jcard0na/The-Open-Book/3d_models/README.md

The symbolic link button.step will be picked up in Kicad to render the buttons.
If you intend to use silicone keycaps, use:
ln -sf keycap-Body.step button.step
Else, for smd push buttons use:
ln -sf TS-1187A-B-A-B.step button.step
