jcard0na/The-Open-Book/3d_models/button.step

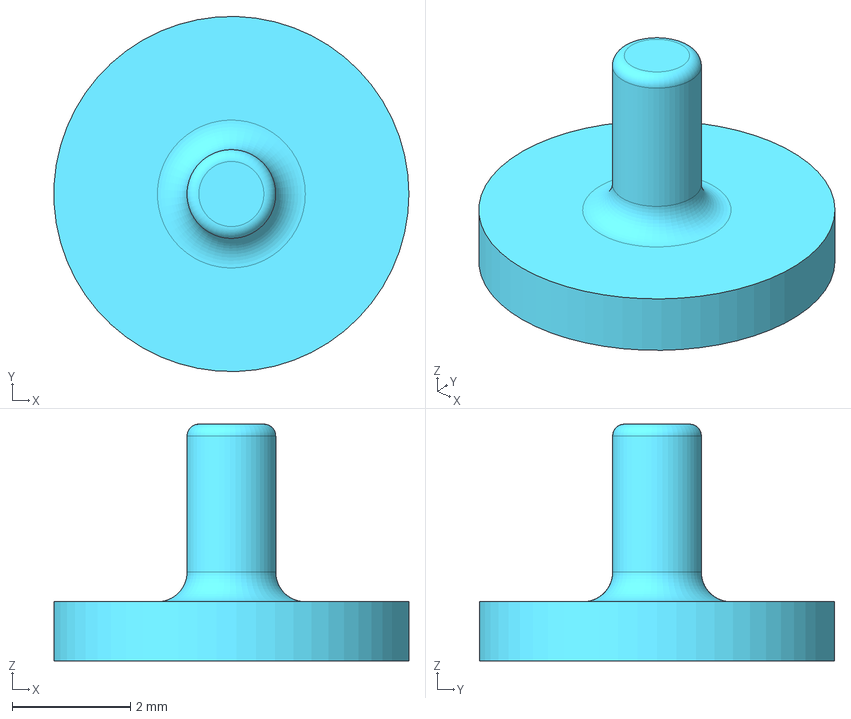
[picture p1: CAD file, 2024-09-22]
3d_models/button.step
6.00 x 6.00 x 4.00 mm
