jcard0na/The-Open-Book/3d_models/ST-TF-003A.step

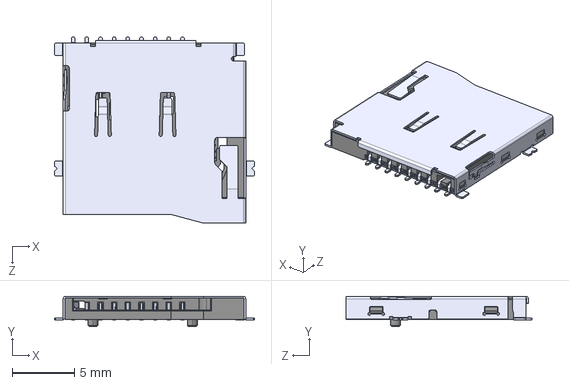
[picture p2: CAD file, 2024-09-21]
3d_models/ST-TF-003A.step
16.1 x 2.45 x 15.0 mm
