jcard0na/The-Open-Book/3d_models/TS-1187A-B-A-B.step

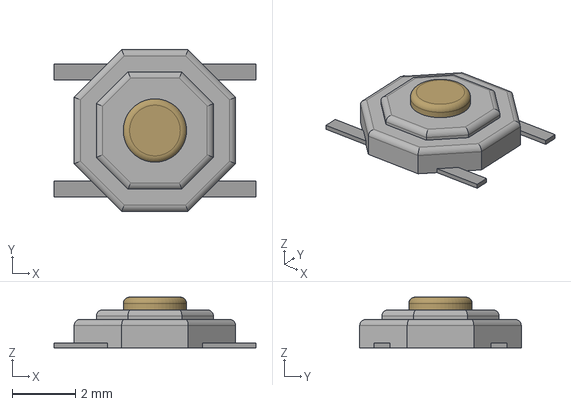
[picture p3: CAD file, 2024-09-21]
3d_models/TS-1187A-B-A-B.step
6.38 x 5.10 x 1.60 mm
