jcard0na/The-Open-Book/(list of files, cad)

Other CAD files:
3d_models/keycap.FCStd
