jcard0na/The-Open-Book/OSO-BOOK-B1/OSO-BOOK-B1.kicad_sch

## KiCad design OSO-BOOK-B1/OSO-BOOK-B1.kicad_sch (2025-03-12)

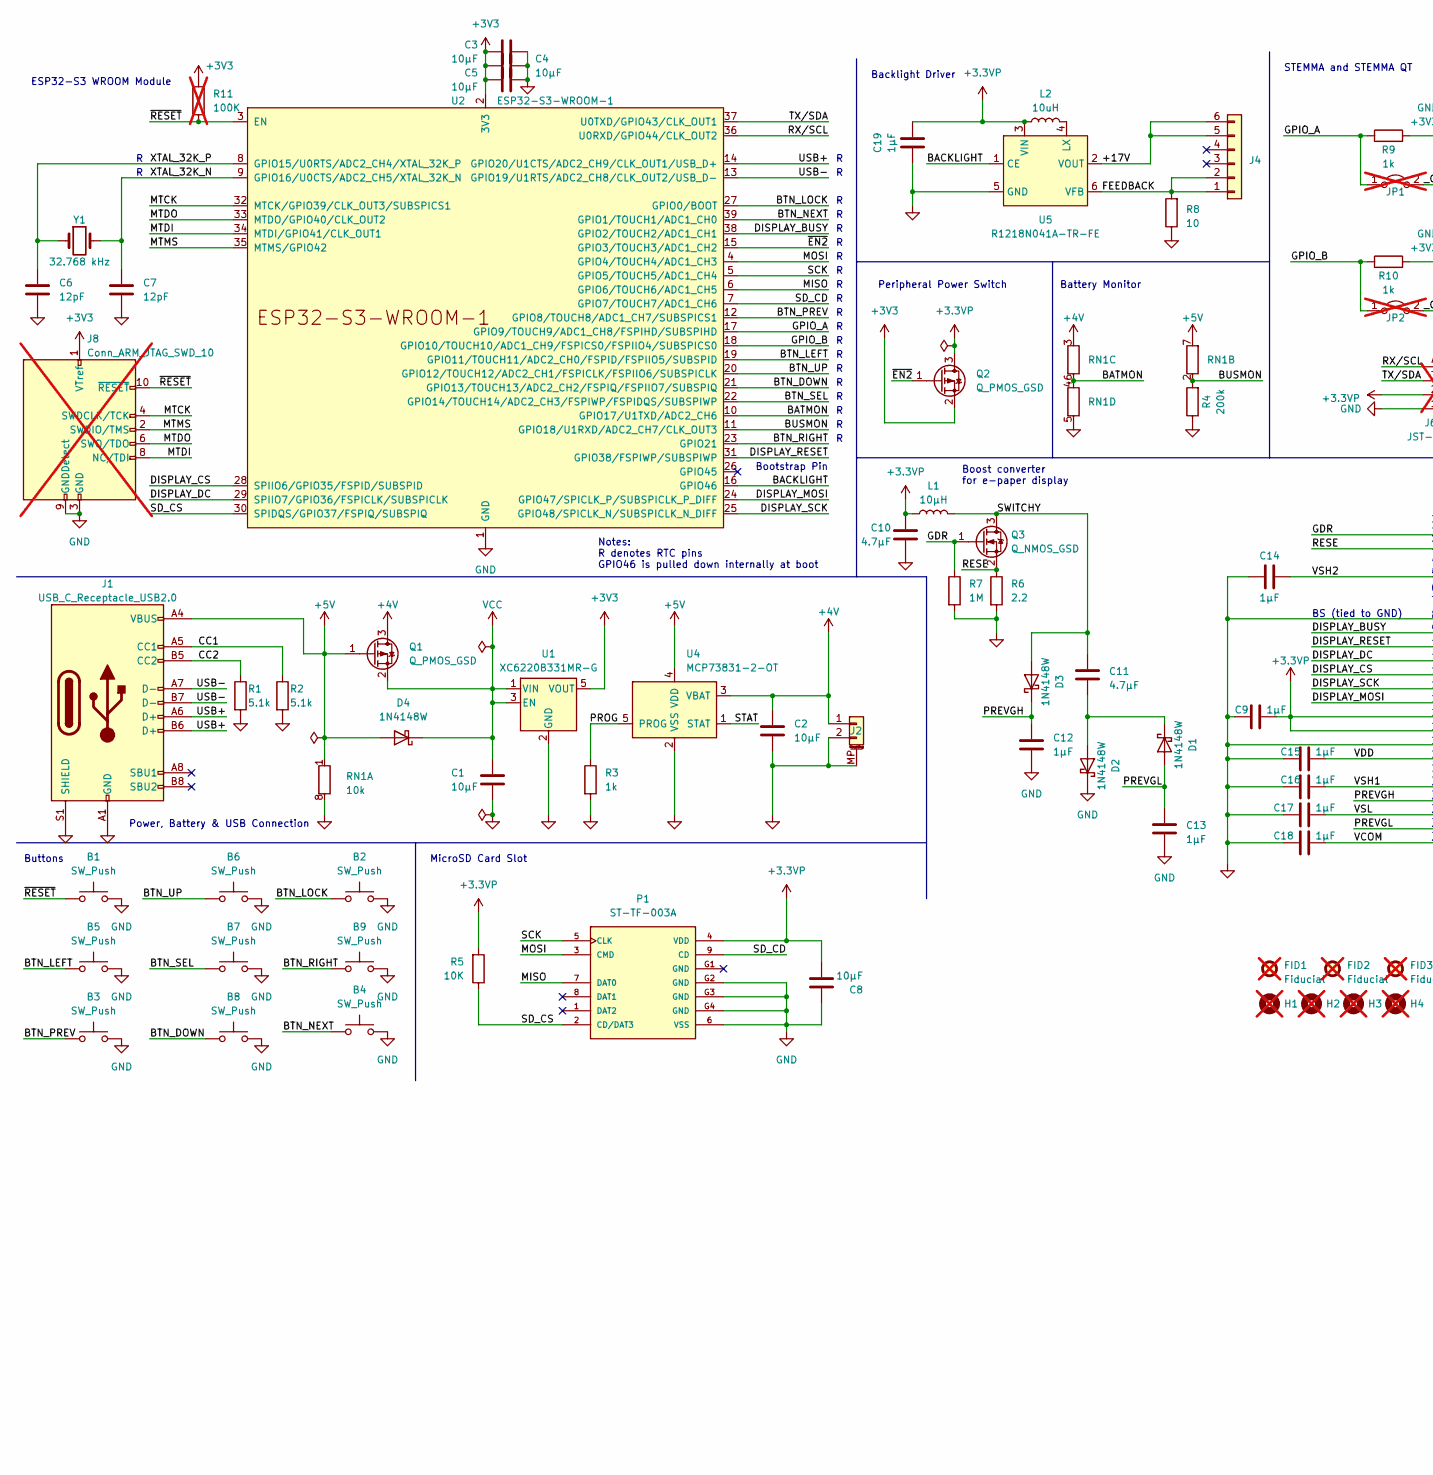
[picture p4: schematic OSO-BOOK-B1.kicad_sch, part in row 1, column 1]

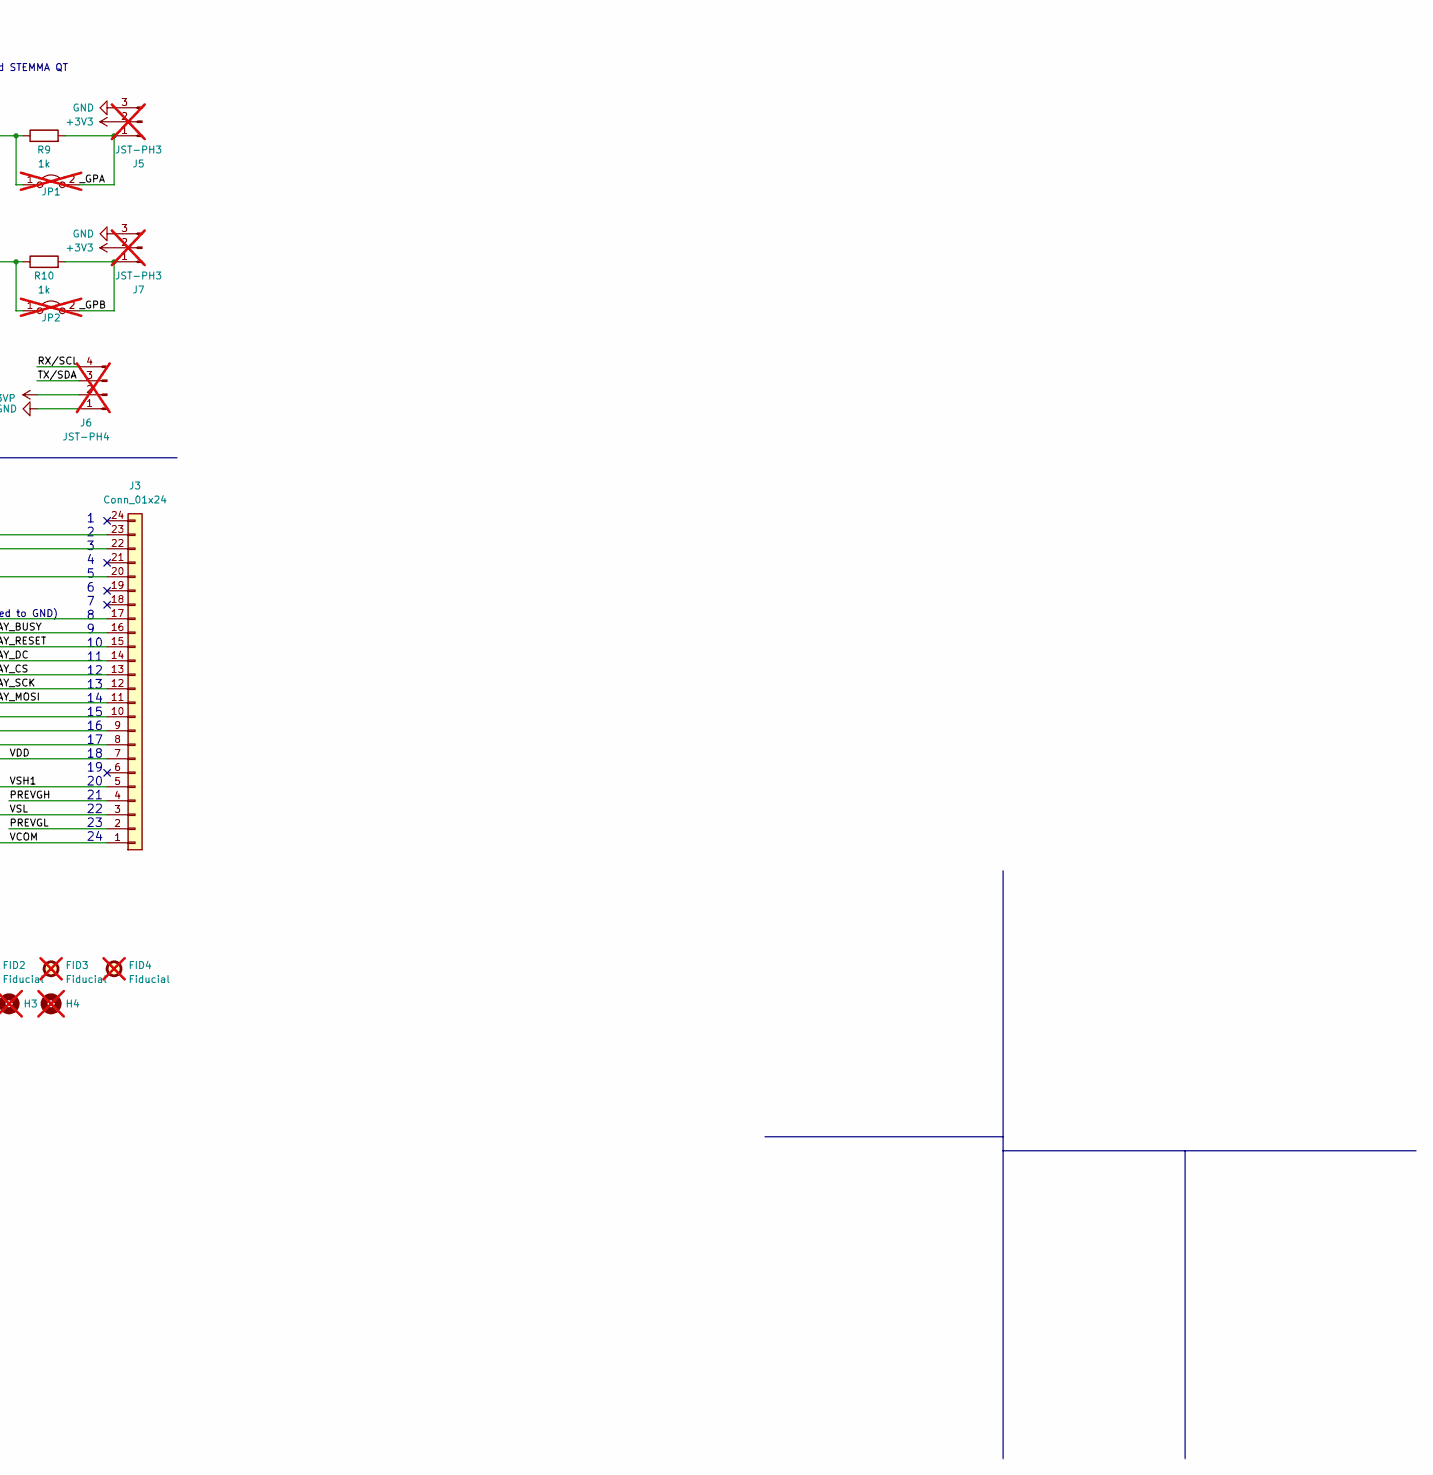
[picture p5: schematic OSO-BOOK-B1.kicad_sch, part in row 1, column 2]

Parts:
B1, B2: SW_Push; Panasonic_EVQPUJ_EVQPUA; JLCPCB C128539
B3, B4, B5, B6, B7, B8, B9: SW_Push; SW_Push_1P1T_XKB_TS-1187A-Silicon-Hybrid; JLCPCB C318884
C1, C2, C3, C4, C5, C8: 10µF; C_1206_3216Metric; JLCPCB C13585
C6, C7: 12pF; C_0603_1608Metric; JLCPCB C38523
C9, C12, C13, C14, C15, C16, C17, C18, C19: 1µF; C_0805_2012Metric; JLCPCB C28323
C10, C11: 4.7µF; C_0805_2012Metric; JLCPCB C1779
D1, D2, D3, D4: 1N4148W; D_SOD-123; JLCPCB C81598
FID1, FID2, FID3, FID4: Fiducial; Fiducial_1mm_Mask2mm; not fitted
H1, H2, H3, H4: MountingHole; MountingHole_2.7mm_M2.5; not fitted
J1: USB_C_Receptacle_USB2.0; USB_C_Receptacle_HRO_TYPE-C-31-M-12; JLCPCB C165948
J2: Conn_01x02_MountingPin; Molex_PicoBlade_53261-0271_1x02-1MP_P1.25mm_Horizontal; JLCPCB C225111
J3: Conn_01x24; TE_2-1734839-4_1x24-1MP_P0.5mm_Horizontal; JLCPCB C262683
J4: Conn_01x06; TE_0-1734839-6_1x06-1MP_P0.5mm_Horizontal; JLCPCB C7465444
J5, J7: JST-PH3; JST_SH_SM03B-SRSS-TB_1x03-1MP_P1.00mm_Horizontal; not fitted
J6: JST-PH4; JST_SH_SM04B-SRSS-TB_1x04-1MP_P1.00mm_Horizontal; not fitted
J8: Conn_ARM_JTAG_SWD_10; PinHeader_2x05_P1.27mm_Vertical_SMD; not fitted
JP1, JP2: Jumper_2_Open; SolderJumper-2_P1.3mm_Open_TrianglePad1.0x1.5mm; not fitted
L1: 10µH; L_0805_2012Metric; JLCPCB C1046
L2: 10uH; L_0805_2012Metric; JLCPCB C1046
P1: ST-TF-003A; SUNTECH_ST-TF-003A; JLCPCB C393941
Q1, Q2: Q_PMOS_GSD; SOT-23; JLCPCB C15127
Q3: Q_NMOS_GSD; SOT-23; JLCPCB C8545
R1, R2: 5.1k; R_0805_2012Metric; JLCPCB C27834
R3, R9, R10: 1k; R_0805_2012Metric; JLCPCB C17513
R4: 200k; R_0805_2012Metric; JLCPCB C17539
R5: 10K; R_0805_2012Metric; JLCPCB C17414
R6: 2.2; R_0805_2012Metric; JLCPCB C17521
R7: 1M; R_0805_2012Metric; JLCPCB C4310
R8: 10; R_0805_2012Metric; JLCPCB C17415
R11: 100K; R_0805_2012Metric; not fitted
RN1: 10k; R_Array_Concave_4x0603; JLCPCB C29718
U1: XC6220B331MR-G; SOT-23-5; JLCPCB C86534
U2: ESP32-S3-WROOM-1; JLCPCB C2913198
U4: MCP73831-2-OT; SOT-23-5; JLCPCB C424093
U5: R1218N041A-TR-FE; SOT-23-6; JLCPCB C6749144
Y1: 32.768 kHz; Crystal_SMD_3215-2Pin_3.2x1.5mm; JLCPCB C32346

Connections:
+3.3VP: C8.2, C9.2, C10.1, C19.2, J3.9, J3.10, J6.2, L1.1, L2.1, P1.4 (VDD), Q2.3 (D), R5.2, U5.3 (VIN)
+3V3: C3.1, C4.1, C5.1, J5.2, J7.2, J8.1 (VTref), Q2.2 (S), R11.1, U1.5 (VOUT), U2.2 (3V3)
+4V: C2.1, J2.1, Q1.3 (D), RN1.3 (R3.1), U4.3 (VBAT)
+5V: D4.2 (A), J1.A4 (VBUS), J1.A9 (VBUS), J1.B4 (VBUS), J1.B9 (VBUS), Q1.1 (G), RN1.1 (R1.1), RN1.7 (R2.2), U4.4 (VDD)
+17V: J4.5, J4.6, U5.2 (VOUT)
BACKLIGHT: U2.16 (GPIO46), U5.1 (CE)
BATMON: RN1.4 (R4.1), RN1.6 (R3.2), U2.10 (GPIO17/U1TXD/ADC2_CH6)
BTN_DOWN: B8.1, U2.21 (GPIO13/TOUCH13/ADC2_CH2/FSPIQ/FSPIIO7/S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)
BTN_LEFT: B5.1, U2.19 (GPIO11/TOUCH11/ADC2_CH0/FSPID/FSPIIO5/S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)
BTN_LOCK: B2.1, U2.27 (GPIO0/BOOT)
BTN_NEXT: B4.1, U2.39 (GPIO1/TOUCH1/ADC1_CH0)
BTN_PREV: B3.1, U2.12 (GPIO8/TOUCH8/ADC1_CH7/SUBSPICS1)
BTN_RIGHT: B9.1, U2.23 (GPIO21)
BTN_SEL: B7.1, U2.22 (GPIO14/TOUCH14/ADC2_CH3/FSPIWP/FSPIDQS/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)
BTN_UP: B6.1, U2.20 (GPIO12/TOUCH12/ADC2_CH1/FSPICLK/FSPIIO6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)
BUSMON: R4.2, RN1.2 (R2.1), U2.11 (GPIO18/U1RXD/ADC2_CH7/CLK_OUT3)
CC1: J1.A5 (CC1), R2.1
CC2: J1.B5 (CC2), R1.1
DISPLAY_BUSY: J3.16, U2.38 (GPIO2/TOUCH2/ADC1_CH1)
DISPLAY_CS: J3.13, U2.28 (SPIIO6/GPIO35/FSPID/SUBSPID)
DISPLAY_DC: J3.14, U2.29 (SPIIO7/GPIO36/FSPICLK/SUBSPICLK)
DISPLAY_MOSI: J3.11, U2.24 (GPIO47/SPICLK_P/SUBSPICLK_P_DIFF)
DISPLAY_RESET: J3.15, U2.31 (GPIO38/FSPIWP/SUBSPIWP)
DISPLAY_SCK: J3.12, U2.25 (GPIO48/SPICLK_N/SUBSPICLK_N_DIFF)
FEEDBACK: J4.1, J4.2, R8.2, U5.6 (VFB)
GDR: J3.23, Q3.1 (G), R7.1
GND: B1.2, B2.2, B3.2, B4.2, B5.2, B6.2, B7.2, B8.2, B9.2, C1.2, C2.2, C3.2, C4.2, C5.2, C6.2, C7.2, C8.1, C9.1, C10.2, C12.2, C13.2, C14.1, C15.1, C16.1, C17.1, C18.1, C19.1, D2.1 (K), J1.A1 (GND), J1.A12 (GND), J1.B1 (GND), J1.B12 (GND), J1.S1 (SHIELD), J2.2, J2.MP (MountPin), J3.8, J3.17, J5.3, J6.1, J7.3, J8.3 (GND), J8.5 (GND), J8.9 (GNDDetect), P1.6 (VSS), P1.G2 (GND), P1.G3 (GND), P1.G4 (GND), R1.2, R2.2, R3.2, R4.1, R6.2, R7.2, R8.1, RN1.5 (R4.2), RN1.8 (R1.2), U1.2 (GND), U2.1 (GND), U2.40 (GND), U2.41 (GND), U4.2 (VSS), U5.5 (GND)
GPIO_A: JP1.1 (A), R9.1, U2.17 (GPIO9/TOUCH9/ADC1_CH8/FSPIHD/SUBSPIHD)
GPIO_B: JP2.1 (A), R10.1, U2.18 (GPIO10/TOUCH10/ADC1_CH9/FSPICS0/FSPIIO4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)
MISO: P1.7 (DAT0), U2.6 (GPIO6/TOUCH6/ADC1_CH5)
MOSI: P1.3 (CMD), U2.4 (GPIO4/TOUCH4/ADC1_CH3)
MTCK: J8.4 (SWDCLK/TCK), U2.32 (MTCK/GPIO39/CLK_OUT3/SUBSPICS1)
MTDI: J8.8 (NC/TDI), U2.34 (MTDI/GPIO41/CLK_OUT1)
MTDO: J8.6 (SWO/TDO), U2.33 (MTDO/GPIO40/CLK_OUT2)
MTMS: J8.2 (SWDIO/TMS), U2.35 (MTMS/GPIO42)
unnamed: C11.1, D1.1 (K), D2.2 (A)
unnamed: L2.2, U5.4 (LX)
PREVGH: C12.1, D3.1 (K), J3.4
PREVGL: C13.1, D1.2 (A), J3.2
PROG: R3.1, U4.5 (PROG)
RESE: J3.22, Q3.2 (S), R6.1
RX/SCL: J6.4, U2.36 (U0RXD/GPIO44/CLK_OUT2)
SCK: P1.5 (CLK), U2.5 (GPIO5/TOUCH5/ADC1_CH4)
SD_CD: P1.9 (CD), U2.7 (GPIO7/TOUCH7/ADC1_CH6)
SD_CS: P1.2 (CD/DAT3), R5.1, U2.30 (SPIDQS/GPIO37/FSPIQ/SUBSPIQ)
STAT: U4.1 (STAT)
SWITCHY: C11.2, D3.2 (A), L1.2, Q3.3 (D)
TX/SDA: J6.3, U2.37 (U0TXD/GPIO43/CLK_OUT1)
USB+: J1.A6 (D+), J1.B6 (D+), U2.14 (GPIO20/U1CTS/ADC2_CH9/CLK_OUT1/USB_D+)
USB-: J1.A7 (D-), J1.B7 (D-), U2.13 (GPIO19/U1RTS/ADC2_CH8/CLK_OUT2/USB_D-)
VCC: C1.1, D4.1 (K), Q1.2 (S), U1.1 (VIN), U1.3 (EN)
VCOM: C18.2, J3.1
VDD: C15.2, J3.7
VSH1: C16.2, J3.5
VSH2: C14.2, J3.20
VSL: C17.2, J3.3
XTAL_32K_N: C7.1, U2.9 (GPIO16/U0CTS/ADC2_CH5/XTAL_32K_N), Y1.2
XTAL_32K_P: C6.1, U2.8 (GPIO15/U0RTS/ADC2_CH4/XTAL_32K_P), Y1.1
_GPA: J5.1, JP1.2 (B), R9.2
_GPB: J7.1, JP2.2 (B), R10.2
~EN2: Q2.1 (G), U2.15 (GPIO3/TOUCH3/ADC1_CH2)
~RESET: B1.1, J8.10 (~RESET), R11.2, U2.3 (EN)

Notes on the sheet:
Backlight Driver
STEMMA and STEMMA QT
Notes: R denotes RTC pins GPIO46 is pulled down internally at boot
Peripheral Power Switch
Power, Battery & USB Connection
1 2 3 4 5 6 7 8 9 10 11 12 13 14 15 16 17 18 19 20 21 22 23 24
Buttons
ESP32-S3 WROOM Module
MicroSD Card Slot
BS (tied to GND)
Bootstrap Pin
Battery Monitor
Boost converter for e-paper display
