jcard0na/The-Open-Book/(commit log)

2024-09-21 Use surface mount push buttons
    These buttons are basic parts at JLCPCB, so really inexpensive to use (1
    cent per part, no setup fee). They can then be covered by a silicone
    cover for moisture protection and good looks. Or even a 3d printed
    cover can do the trick.
    [OSO-BOOK-B1.kicad_sch, TS-1187A-B-A-B.step]
2024-09-21 Switch some parts
    - Pick a different SD-Card that is widely available
    - Use JLCPCB basic parts when possible
    [OSO-BOOK-B1.kicad_sch, ST-TF-003A.step]
2024-09-21 Packing script
    [OSO-BOOK-B1.csv, OSO-BOOK-B1.kicad_sch]
2024-09-22 More work on the buttons: rubber or SMD option
    [OSO-BOOK-B1.kicad_sch, button.step, keycap-Body.step, keycap.FCStd]
2024-09-22 Increase ground via size for ESP32 footprint
    This makes is easier to hand solder this part when no soldering iron is
    at hand.
2024-09-22 Use correct JLCPCB part number for ESP32-S3 module
    [OSO-BOOK-B1.kicad_sch]
2025-03-12 Pick alternate part for bat connector
    [OSO-BOOK-B1.csv, OSO-BOOK-B1.kicad_sch, button.step]
